YamamaSawalmeh/beeguard_Project/docs/images/app-feeding.jpg

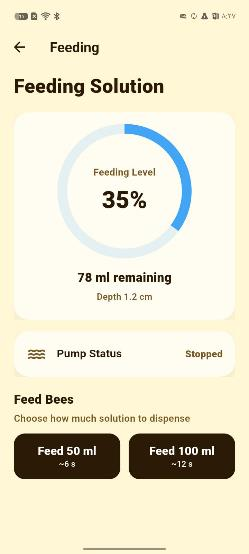
docs/images/app-feeding.jpg
