YamamaSawalmeh/beeguard_Project/docs/images/app-security.jpg

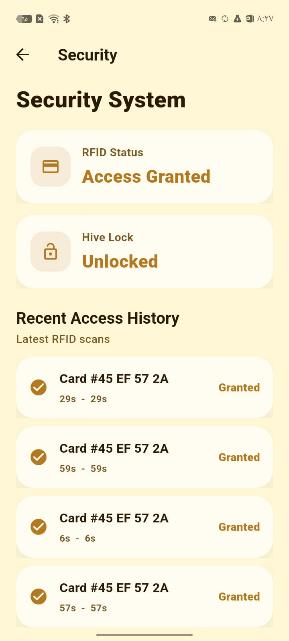
docs/images/app-security.jpg
