YamamaSawalmeh/beeguard_Project/SETUP_V5.md

# BeeGuard v5 — دليل التشغيل والمعايرة

هذا الملف بيشرح شو تغيّر وشو لازم تعمله قبل ما النظام يشتغل صح.

---

## ١. أهم إشي: الواي فاي لازم يكون نفسه على الثلاث بوردات

**ESP-NOW بيوصل بس بين بوردات على نفس قناة الواي فاي.** والقناة بتتحدد من
الراوتر اللي البورد متصلة فيه — مش من إعداد بالكود.

قبل التعديل كان الوضع:

| البورد | SSID |
|---|---|
| المتحكم الرئيسي | `GP` |
| الكاميرا | `MSI` |
| بورد الصوت | ما كان فيها واي فاي أصلاً |

يعني حتى لو الـ MAC صح، `esp_now_send()` بترجّع `ESP_OK` بس الباكت بتضيع
بالهوا. هذا السبب الأساسي إنه الحرارة والرطوبة والصوت ما كانوا يوصلوا للتطبيق.

هلأ الثلاثة متضبطين على `MSI` / `123456789`. **إذا شبكتك اسمها غير، غيّرها
بالثلاث ملفات مع بعض:**

- `BeeGuard_Main_Controller.ino` → `WIFI_SSID` / `WIFI_PASSWORD`
- `BEE_HIVE_MONITOR.ino` → `WIFI_SSID` / `WIFI_PASSWORD`
- `esp32cam_hive_guard.ino` → `ssid` / `password`

**طريقة التأكد:** كل بورد بتطبع القناة على السيريال وقت الإقلاع:

```
[WiFi] Channel: 6  (camera + audio boards MUST match)
```

لازم الثلاث أرقام تكون نفسها. إذا مش نفسها، ESP-NOW ما رح يشتغل.

> ملاحظة: الموبايل كمان لازم يكون على نفس الشبكة عشان يشوف ستريم الكاميرا
> (`http://192.168.137.150/`) — هذا IP محلي، مش على الإنترنت.

---

## ٢. المعايرة — بدونها الأرقام غلط

### أ) معايرة الميزان (HX711)

`SCALE_CALIBRATION_FACTOR = -7050.0` اللي كان بالكود هو رقم من مثال المكتبة،
مش رقم خليتك، وبيطلع **باوند مش كيلو**. لازم تقيسه:

1. شغّل الخلية فاضية (بدون وزن على الحساس).
2. من التطبيق أو من Firebase console: `commands/tare_scale = true`.
   البورد بتعمل tare وبتخزّن الصفر بـ `calibration/tare_offset`.
3. حط وزن معروف (مثلاً ٥ كيلو).
4. اقرأ `hive_status/weight` من Firebase.
5. احسب: `عامل_جديد = العامل_الحالي × (القراءة ÷ الوزن_الحقيقي)`
6. اكتب الناتج بـ `calibration/scale_factor` بالـ Firebase console.
   البورد بتقراه عند كل إقلاع — **مش لازم ترفع الكود من جديد**.

> **مهم:** الكود القديم كان بيعمل `scale.tare()` كل مرة بالـ `setup()`، يعني
> كل ريستارت الوزن بيرجع صفر والخلية عليه. هذا انشال — الصفر صار محفوظ
> بـ Firebase وبيرجع لحاله بعد الكهرباء.

### ب) معايرة خزان التغذية (الألتراسونيك)

المعادلة الحسابية نفسها كانت **صح**:

```
waterHeight = CONTAINER_HEIGHT - (distance - SENSOR_TO_TOP)
```

- خزان فاضي: المسافة = ٤ + ٣٫٥ = ٧٫٥ سم → الارتفاع = ٠ ✓
- خزان مليان: المسافة = ٤ سم → الارتفاع = ٣٫٥ ✓

**بس كان فيها باغ خطير:** لما `pulseIn()` تعمل timeout بترجّع `0`، والمعادلة
كانت بتحسب `3.5 - (0 - 4) = 7.5` → بعد الـ constrain بتطلع **١٠٠٪ مليان**.
يعني حساس ميّت كان بيتقرأ خزان مليان — بالضبط عكس اللي بدك ياه من تحذير.

الجديد:
- ٥ قراءات وبناخد الـ **median** (مش المتوسط — عشان صدى شارد ينرمى مش يأثر)
- timeout → `NAN` → بيضل يعرض آخر قراءة صحيحة + بيطلع تنبيه `sensor_fault`
- سرعة الصوت صارت متعوّضة بالحرارة: `331.3 + 0.606×T` م/ث
- بيحسب كمان **الحجم المتبقي بالمليلتر** — أهم من النسبة لما تكون بدك تعرف
  إذا بيكفي لجرعة ١٠٠ مل

قيس الأبعاد الحقيقية واكتبها بـ `calibration`:

| المفتاح | يعني | الافتراضي |
|---|---|---|
| `sensor_to_top_cm` | من وجه الحساس لحافة الخزان | 4.0 |
| `container_height_cm` | من الحافة لقاع الخزان | 3.5 |
| `container_diameter_cm` | قطر الخزان (لحساب المليلتر) | 9.0 |

> ملاحظة: HC-SR04 أقل مسافة بيقيسها ≈ ٢ سم. مع `sensor_to_top_cm = 4`
> والخزان مليان المسافة بتصير ٤ سم — قريبة بس مقبولة. إذا نزّلت الحساس أقرب
> من هيك، القراءات بتصير غلط.

### ج) خط الأساس للعسل (baseline)

بدون baseline، تقدير العسل بيحسب **وزن الخلية كلها** (الصندوق والبراويز
والنحل) على إنه عسل — يعني ٢٤ كيلو عسل، وهذا غلط فاضح مش تقريب.

من شاشة **Honey Collection** اضغط **Set baseline now** لما تكون الخلية بدون
عسل جاهز للقطف. بعدها:

```
estimated_honey = (الوزن الحالي − baseline) × honey_fraction
```

`honey_fraction` افتراضياً `0.85` — لأنه مش كل زيادة الوزن عسل، جزء منها شمع
وحضنة ونحل. عدّلها بـ `calibration/honey_fraction` بعد ما تقطف أول مرة وتوزن
الناتج الفعلي.

---

## ٣. شو تغيّر بالتفصيل

### مدخل الخلية (Open / Narrow)

انعكست الزوايا بالفيرموير:

```c
#define ENTRANCE_OPEN_ANGLE   180   // كانت 0
#define ENTRANCE_NARROW_ANGLE 0     // كانت 180
```

يعني السلوك الفيزيائي انعكس عن اللي كان: "Open Entrance" بالتطبيق هلأ بتعطي
الوضع اللي كان "Narrow" بيعطيه. أسماء الأزرار وقيم Firebase ضلّت زي ما هي
وصحيحة — إذا ركّبت السيرفو بالعكس مستقبلاً، بدّل الرقمين بس.

**ليش بالفيرموير مش بتبديل أسماء الأزرار بالتطبيق؟**
لأنه المدخل مش بس أزرار — الكاميرا لما تكشف دبور، المتحكم بينادي
`narrowEntrance()` أوتوماتيكياً. لو بدّلنا الأسماء بالتطبيق بس، بتصير
`entrance = "narrow"` معناها فيزيائياً "مفتوح"، ووقتها الاستجابة التلقائية
**بتفتح** المدخل لما ييجي دبور بدل ما تضيّقه — يعني بتصير تدعوه يفوت.
تبديل الزوايا بالفيرموير بيصلّح الاتجاه الفيزيائي وبيخلي كل المعاني صحيحة.

> إذا اللي كنت تقصده فعلاً هو تبديل نص الأزرار بالواجهة بس، خبّرني — بس
> الاستجابة التلقائية للدبور بدها تنعكس معها عشان تضل صح.

**فتح تلقائي بعد ما يروح الدبور (سلوك جديد):**
قبل هيك، أول ما تكشف الكاميرا دبور المدخل بيضيق **وبيضل ضيّق للأبد** لحد ما
حدا يفتح التطبيق ويوسّعه. يعني دبور واحد مرّ الصبح بيخلي الخلية مخنوقة تهوية
وحركة سروح طول اليوم إذا ما انتبهت.

هلأ بيرجع يفتح لحاله بعد **١٠ دقايق** بدون أي كشف:

```c
const unsigned long HORNET_REOPEN_DELAY_MS = 10UL * 60UL * 1000UL;
```

- التأخير موجود عشان ما يفتح ويسكّر كل ما الدبور يدخل ويطلع من كادر الكاميرا.
- إذا **إنت** ضيّقت المدخل من التطبيق، بيضل زي ما تركته — الفتح التلقائي
  بيلغي بس التضييق اللي عمله النظام نفسه.
- إذا بدك ترجعه للسلوك القديم (يضل ضيّق لحد ما تفتحه بإيدك)، حط القيمة `0`.

### الكاميرا

- **الكشف صار شغال ٢٤ ساعة.** قبل هيك كان الكشف جوّا `stream_handler()` بس —
  يعني الخلية كانت محروسة فقط لما يكون حدا فاتح الفيديو. هلأ `loop()` بتفحص
  فريم كل نص ثانية لما ما يكون في متفرج.
- **endpoint جديد `/status`** بيرجّع JSON فيه وقت آخر كشف مؤكد:
  ```json
  {"count":0,"detected":false,"ever_detected":true,"since_seconds":142,
   "last_count":2,"total_detections":7,"uptime_seconds":9310}
  ```
- **نبضة كل ٣٠ ثانية** للمتحكم الرئيسي، عشان يعرف إنه الكاميرا عايشة حتى لو
  ما في دبابير (قبل هيك كانت بتبعث بس عند تغيّر الحالة، فبتظهر أوفلاين دايماً).
- الكاميرا ما عندها ساعة، فبتبعث "كم ثانية صار من آخر كشف" والمتحكم الرئيسي
  (اللي عنده NTP) بيحوّلها لوقت حقيقي. فايدة إضافية: لو المتحكم عمل ريستارت،
  بيرجّع وقت آخر كشف من الكاميرا بدل ما يضيع.

### بورد الصوت

كانت **ما بتبعث ولا إشي** — لا ESP-NOW ولا واي فاي، النتيجة بتوقف عالشاشة.
انضاف:

- إرسال ESP-NOW كل ٢٠ ثانية (حرارة + رطوبة)
- إرسال نتيجة التصنيف بعد كل تحليل
- **تحليل تلقائي كل ١٥ دقيقة** — قبل هيك كان لازم حدا يوقف جنب الخلية ويضغط
  الزر عشان تتحدث النتيجة
- كرت SD خربان ما عاد يعلّق البورد بـ `while(1)` — بتكمل تبعث حرارة ورطوبة

**ترجمة أسماء الأصناف:** الموديل بيطلع `Active` / `Queen_Loss`، بينما التطبيق
والمتحكم بيفهموا `Normal` / `Swarming` / `Queen Loss`. الترجمة صارت بدالة
`normalizeLabel()` — لو دربت الموديل من جديد بأسماء غير، عدّل هاي الدالة بس.

> بدون هاي الترجمة، كل قراءة كانت بتنحسب غير طبيعية و `health_score` بيضل
> ناقص ٣٠ نقطة على طول.

### الإشعارات

- **وقت حقيقي (NTP)** بدل `"just now"` الثابتة و `millis()/1000 + "s"`
- **severity**: `info` / `warning` / `critical`
- **throttle**: التنبيهات المستمرة (مي قليلة، حرارة عالية) بتنكتب مرة كل ١٥
  دقيقة. قبل هيك كانت بتضيف node جديدة **كل ٣٠ ثانية للأبد** طول ما المستوى
  واطي — يعني آلاف الـ nodes بالأسبوع.
- أحداث جديدة: فتح/سكر الباب، الدخان، الطرمبة، التغذية، RFID، الدبور
  وانتهاؤه، ضيق/فتح المدخل، القطف، المعايرة، عطل الحساسات، انقطاع البوردات،
  الإقلاع.
- التطبيق: badge بعدد غير المقروء على الداشبورد، فلترة، و"تعليم الكل كمقروء".

### الإنتاج

- `production/history/YYYY-MM-DD` — سجل يومي حقيقي.
  الرسم البياني كان `[today×0.5, today×0.7, today×0.6, ...]` — شكل ثابت ما
  بيتغيّر مهما عملت الخلية. هلأ بيرسم أرقام فعلية.
- كشف القطف: نزول مفاجئ بالوزن (> ٥٠٠ غم) والباب مفتوح → بينسجل كقطف،
  والـ baseline بينزل معه.
- عدّادات أسبوعية وشهرية بتصفّر مع بداية الأسبوع/الشهر.

---

## ٤. قائمة التحقق بعد الرفع

ارفع الثلاث ملفات، وبعدين افحص بالترتيب:

1. **السيريال لكل بورد**: نفس رقم القناة على الثلاثة؟
2. **المتحكم**: `[TIME] 2026-08-20 14:33:10` — إذا طلع `uptime ...s` يعني NTP
   فشل، افحص الإنترنت.
3. **بورد الصوت**: `[ESP-NOW] Sent T=34.2 H=61.8 Normal 0% fresh=0`
4. **المتحكم**: `[Firebase] T:34.2 H:61.8 W:...` — إذا الحرارة صفر، الباكتات
   مش واصلة (ارجع للنقطة ١).
5. **Firebase console**: `hive_status/audio_node_online` و
   `hive_status/camera_node_online` لازم يصيروا `true` خلال دقيقتين.
6. **المتصفح**: افتح `http://192.168.137.150:81/status` — لازم يرجّع JSON.
7. **التطبيق**: شاشة Hornet Detection — الفيديو شغال وبتحته "Last Detection".
8. اعمل معايرة الميزان والخزان والـ baseline (القسم ٢).

### إذا الفيديو ما ظهر بالتطبيق

- افتح `http://192.168.137.150/` بمتصفح الموبايل. إذا ما اشتغل هناك
  كمان، المشكلة بالشبكة مش بالتطبيق.
- الموبايل لازم يكون على نفس شبكة الكاميرا.
- Android: `network_security_config.xml` بيسمح بـ HTTP العادي (مضاف).
- iOS: أول مرة بيطلع سؤال إذن "Local Network" — لازم توافق.
- IP الكاميرا محفوظ بـ `camera/stream_url` بـ Firebase، فإذا تغيّر عدّله من
  الـ console بدون ما ترفع التطبيق من جديد.

---

## ٥. ملاحظة على الذاكرة (بورد الصوت)

إضافة الواي فاي على بورد فيها Edge Impulse + I2S + SD بتاخد ذاكرة. البورد
بتطبع الفاضي عند الإقلاع:

```
[MEM] Free heap before WiFi: 245678 bytes
[MEM] Free heap after  WiFi: 198432 bytes
```

إذا الرقم الثاني نزل تحت ~٥٠ كيلوبايت، التصنيف ممكن يفشل بـ out-of-memory.
الحل وقتها: قلّل `I2S_READ_LEN` أو استعمل بورد فيها PSRAM.

---

## ٦. تحديثات v5.1 (حسب ملاحظاتك من الميدان)

### أ) رابط الستريم صار على الجذر
الفيديو المباشر هلأ على **`http://192.168.137.150/`** بالضبط (بورت 80، بدون
`:81/stream`). داخلياً بدّلنا البوردات: بورت 80 مخصّص للستريم بس (لأن معالج
الستريم بيحبس الخيط)، و`/status` و`/count` واللوحة انتقلوا لبورت 81. التطبيق
وقاعدة البيانات (`camera/stream_url`) صاروا يشيروا للجذر تلقائياً.

### ب) السيرفو ما بتتحرك رغم إنه الكشف شغال → صار البث broadcast
المشكلة إنه ESP-NOW كان بيبعت لـ MAC محدد للمتحكم
(`EC:E3:34:45:C6:94`). لو هذا الـ MAC مش مطابق للـ MAC الحقيقي تبع المتحكم،
`esp_now_send` بترجّع `ESP_OK` بس الباكت بتضيع — فالكشف يشتغل والسيرفو ما
بتتحرك، بالضبط اللي وصفته.

الحل: الكاميرا صارت تبعت **broadcast** (`FF:FF:FF:FF:FF:FF`) بدل MAC محدد.
استقبال ESP-NOW ما بيصفّي حسب المرسل، فالمتحكم بيستقبلها بغض النظر عن الـ MAC.
كمان ضفنا **callback تأكيد تسليم** بيطبع على سيريال الكاميرا:

```
[ESP-NOW] delivery OK        <- وصلت للمتحكم
[ESP-NOW] delivery FAIL (no ACK)  <- ما وصلت: القناة غلط أو المتحكم مطفّي
```

**للتشخيص:** إفتح Serial Monitor للكاميرا لما تكشف دبور. لو طلع `delivery OK`
والسيرفو ما تحرّكت → المشكلة بتوصيل السيرفو أو المتحكم. لو `FAIL` دايماً →
البوردتين مش على نفس قناة الواي فاي (تأكد إنهم على نفس الراوتر MSI، وقارن رقم
`[WiFi] Channel:` على البوردتين).

> إذا بعرفت الـ MAC الحقيقي للمتحكم (بيطبعه عند الإقلاع: `[ESP-NOW] MAC: ...`)
> وحابب ترجع unicast، حدّث `ESP32_MAIN_MAC` بالكاميرا — بس broadcast بيشتغل
> بدون ما تعرفه.

### ج) الوزن التقديري بيضل فاضي → baseline افتراضي ٤ كيلو
حطينا baseline افتراضي **٤ كيلو** (وزن الصندوق الفاضي تقريباً) بالفيرموير
وقاعدة البيانات والتطبيق، فقيمة "Estimated Honey Ready" ما عادت تطلع فاضية.
التقدير = `(وزن الخلية − ٤) × 0.85`. التطبيق كمان بيحسبها محلياً لو المتحكم
لسا ما كتبها، فبتشوف رقم فوراً.

> ملاحظة مهمة: هذا رقم **عرض** مؤقت. الميزان نفسه (`scale_factor = -7050`)
> لسا بدو معايرة حقيقية (القسم ٢-أ) عشان وزن الخلية يطلع صح — بدونها الوزن
> غلط والتقدير المبني عليه غلط. لما تعاير وتضبط baseline حقيقي من زر
> **Set Baseline**، بتصير الأرقام دقيقة.
