YamamaSawalmeh/beeguard_Project/firmware/BEE_HIVE_MONITOR/BEE_HIVE_MONITOR.ino

/*
 
  INMP441 (I2S Mic)
    SCK/BCLK -> GPIO 27
    WS/LRCL  -> GPIO 13
    SD/DOUT  -> GPIO 34
    VCC      -> 3.3V
    GND      -> GND

  MicroSD (SPI)
    CS   -> GPIO 5
    SCK  -> GPIO 18
    MISO -> GPIO 19
    MOSI -> GPIO 26
    VCC  -> 5V 
    GND  -> GND

 
    RECORD  -> GPIO 32
    ANALYZE -> GPIO 33

   LCD (I2C)
    SDA -> GPIO 21
    SCL -> GPIO 25
    VCC -> حسب الشاشة
    GND -> GND

  DHT11
    DATA -> GPIO 4   
 (Library Manager):
    - LiquidCrystal I2C  (Frank de Brabander أو Marco Schwartz)
    - DHT sensor library (Adafruit)
    - Adafruit Unified Sensor 
    - ff_inferencing (   Active / Queen_Loss)
  ============================================================================
*/

#include <driver/i2s.h>
#include <SPI.h>
#include <SD.h>
#include <Wire.h>
#include <LiquidCrystal_I2C.h>
#include <DHT.h>
#include <math.h>
#include <WiFi.h>
#include <esp_now.h>
#include <esp_wifi.h>
#include <ff_inferencing.h>


#define WIFI_SSID     "MSI"
#define WIFI_PASSWORD "123456789"

uint8_t ESP32_MAIN_MAC[] = { 0xEC, 0xE3, 0x34, 0x45, 0xC6, 0x94 };

#define MSG_SENSOR 1
#define MSG_CAM    2

typedef struct __attribute__((packed)) {
  uint8_t msgType;         // MSG_SENSOR
  float   temperature;
  float   humidity;
  char    soundResult[20];
  uint8_t confidence;      
  uint8_t freshAnalysis;   
} SensorData;

char lastSoundLabel[20] = "Unknown";
int  lastSoundConfidence = 0;

bool espNowReady = false;
unsigned long lastEspNowSend = 0;
const unsigned long ESPNOW_SEND_INTERVAL = 20000UL;   //   

const unsigned long AUTO_ANALYZE_INTERVAL = 15UL * 60UL * 1000UL;  //   
unsigned long lastAutoAnalyze = 0;



// ---- INMP441 (I2S) ----
#define I2S_BCLK   GPIO_NUM_27
#define I2S_WS     GPIO_NUM_13
#define I2S_SD     GPIO_NUM_34
#define I2S_PORT            I2S_NUM_0
#define I2S_SAMPLE_RATE     (16000)
#define I2S_READ_LEN        (16 * 1024)
#define BYTES_PER_SAMPLE    (2)

// ---- MicroSD (SPI) ----
#define SD_CS    5
#define SD_SCK   18
#define SD_MISO  19
#define SD_MOSI  26
SPIClass sdSPI(VSPI);

// ---- الأزرار ----
#define BTN_RECORD   32
#define BTN_ANALYZE  33
#define DEBOUNCE_MS  250

#define LCD_ADDR  0x27
#define LCD_COLS  16
#define LCD_ROWS  2
#define LCD_SDA   21
#define LCD_SCL   25
LiquidCrystal_I2C lcd(LCD_ADDR, LCD_COLS, LCD_ROWS);

// ---- DHT11 ----
#define DHT_PIN   4     
#define DHT_TYPE  DHT11
DHT dht(DHT_PIN, DHT_TYPE);


#define RECORD_MINUTES        1
#define RECORD_SECONDS_LONG   (RECORD_MINUTES * 60UL)
#define ANALYZE_SECONDS       10

#define TARGET_DBFS   -20.0
#define PEAK_LIMIT    0.99
const int headerSize = 44;

const char* ANALYZE_RAW_FILE  = "/analyze_raw.wav";
const char* ANALYZE_PROC_FILE = "/analyze_proc.wav";

// ============================================================================
// ============================================================================
static double dc_x_prev = 0.0;
static double dc_y_prev = 0.0;
const double DC_FILTER_R = 0.995;

static inline double dc_block(double x) {
  double y = x - dc_x_prev + DC_FILTER_R * dc_y_prev;
  dc_x_prev = x;
  dc_y_prev = y;
  return y;
}

struct BiquadCoeffs { double b0, b1, b2, a1, a2; };
struct BiquadState  { double z1 = 0.0, z2 = 0.0; };

static const BiquadCoeffs sections[4] = {
  { 0.0086086972,  0.0172173944,  0.0086086972, -0.9321840550,  0.2476487208 },
  { 1.0000000000,  2.0000000000,  1.0000000000, -1.1438490990,  0.6042562289 },
  { 1.0000000000, -2.0000000000,  1.0000000000, -1.9235752203,  0.9253348864 },
  { 1.0000000000, -2.0000000000,  1.0000000000, -1.9708723639,  0.9724296607 }
};
static BiquadState states[4];

static inline double bandpass_filter_sample(double x) {
  double in = x;
  for (int s = 0; s < 4; s++) {
    double out = sections[s].b0 * in + states[s].z1;
    states[s].z1 = sections[s].b1 * in - sections[s].a1 * out + states[s].z2;
    states[s].z2 = sections[s].b2 * in - sections[s].a2 * out;
    in = out;
  }
  return in;
}

static void resetFilters() {
  dc_x_prev = 0.0;
  dc_y_prev = 0.0;
  for (int s = 0; s < 4; s++) { states[s].z1 = 0.0; states[s].z2 = 0.0; }
}

// ============================================================================
// ============================================================================
static int16_t clsBuffer[EI_CLASSIFIER_RAW_SAMPLE_COUNT];

static int classify_signal_get_data(size_t offset, size_t length, float *out_ptr) {
  numpy::int16_to_float(&clsBuffer[offset], out_ptr, length);
  return 0;
}

// ============================================================================
// ============================================================================
enum SystemState { STATE_IDLE, STATE_RECORDING, STATE_ANALYZING, STATE_DONE_MSG };
volatile SystemState sysState = STATE_IDLE;

unsigned long lastBtnRecord  = 0;
unsigned long lastBtnAnalyze = 0;
unsigned long lastSensorUpdate = 0;
unsigned long doneMsgSince = 0;

float lastTemp = NAN;
float lastHum  = NAN;

bool sdReady = false;


void normalizeLabel(const char *raw, char *out, size_t outLen) {
  String s = String(raw);
  s.trim();
  String lower = s;
  lower.toLowerCase();

  const char *mapped;
  if (lower == "active" || lower == "normal" || lower == "healthy") {
    mapped = "Normal";
  } else if (lower == "queen_loss" || lower == "queenloss" || lower == "queen loss") {
    mapped = "Queen Loss";
  } else if (lower == "swarm" || lower == "swarming") {
    mapped = "Swarming";
  } else if (lower.length() == 0) {
    mapped = "Unknown";
  } else {
    mapped = s.c_str();
  }

  strncpy(out, mapped, outLen - 1);
  out[outLen - 1] = '\0';
}

void espNowInit() {
  WiFi.mode(WIFI_STA);
  WiFi.setSleep(false);   

 
  WiFi.begin(WIFI_SSID, WIFI_PASSWORD);
  Serial.print("[WiFi] Connecting");
  unsigned long start = millis();
  while (WiFi.status() != WL_CONNECTED && millis() - start < 15000UL) {
    delay(300);
    Serial.print(".");
  }
  Serial.println();

  if (WiFi.status() == WL_CONNECTED) {
    Serial.println("[WiFi] Connected: " + WiFi.localIP().toString());
  } else {
    Serial.println("[WiFi] NOT connected — ESP-NOW may be on the wrong channel");
  }
  Serial.printf("[WiFi] Channel: %d  (must match the main controller)\n", WiFi.channel());
  Serial.println("[ESP-NOW] My MAC: " + WiFi.macAddress());

  if (esp_now_init() != ESP_OK) {
    Serial.println("[ESP-NOW] INIT FAILED");
    return;
  }

  esp_now_peer_info_t peer = {};
  memcpy(peer.peer_addr, ESP32_MAIN_MAC, 6);
  peer.channel = 0;       
  peer.encrypt = false;

  if (esp_now_add_peer(&peer) != ESP_OK) {
    Serial.println("[ESP-NOW] Failed to add main controller as peer");
    return;
  }

  espNowReady = true;
  Serial.println("[ESP-NOW] Ready — sending to EC:E3:34:45:C6:94");
}

void sendSensorPacket(bool freshAnalysis) {
 
  lastEspNowSend = millis();
  if (!espNowReady) return;

  SensorData pkt = {};
  pkt.msgType = MSG_SENSOR;

  
  pkt.temperature   = lastTemp;
  pkt.humidity      = lastHum;
  pkt.confidence    = (uint8_t)constrain(lastSoundConfidence, 0, 100);
  pkt.freshAnalysis = freshAnalysis ? 1 : 0;
  strncpy(pkt.soundResult, lastSoundLabel, sizeof(pkt.soundResult) - 1);

  esp_err_t res = esp_now_send(ESP32_MAIN_MAC, (uint8_t *)&pkt, sizeof(pkt));
  lastEspNowSend = millis();

  if (res == ESP_OK) {
    Serial.printf("[ESP-NOW] Sent T=%.1f H=%.1f %s %d%% fresh=%d\n",
                  pkt.temperature, pkt.humidity, pkt.soundResult,
                  pkt.confidence, pkt.freshAnalysis);
  } else {
    Serial.printf("[ESP-NOW] Send failed (%d)\n", res);
  }
}


void refreshDht() {
  float t = dht.readTemperature();
  float h = dht.readHumidity();
  if (!isnan(t) && !isnan(h)) {
    lastTemp = t;
    lastHum  = h;
  }
}


  delay(300);

  pinMode(BTN_RECORD, INPUT_PULLUP);
  pinMode(BTN_ANALYZE, INPUT_PULLUP);

  Wire.begin(LCD_SDA, LCD_SCL);
  lcd.init();
  lcd.backlight();
  lcdShowIdle();

  dht.begin();
  refreshDht();        
  i2sInit();

  sdSPI.begin(SD_SCK, SD_MISO, SD_MOSI, SD_CS);
  if (!SD.begin(SD_CS, sdSPI)) {
   
    sdReady = false;
    Serial.println("!!! فشل تهيئة SD Card — التسجيل والتحليل معطلين");
    lcd.clear();
    lcd.setCursor(0, 0); lcd.print("SD Card ERROR");
    lcd.setCursor(0, 1); lcd.print("Sensors only");
    delay(2500);
  } else {
    sdReady = true;
    Serial.println("SD Card جاهزة");
  }

 
  Serial.printf("[MEM] Free heap before WiFi: %u bytes\n", ESP.getFreeHeap());
  espNowInit();
  Serial.printf("[MEM] Free heap after  WiFi: %u bytes\n", ESP.getFreeHeap());

  sendSensorPacket(false);   
  lastAutoAnalyze = millis();

  lcdShowIdle();
  Serial.println("جاهز! زر RECORD يبدأ تسجيل، زر ANALYZE يحلل عينة 10 ثواني.");
}

void loop() {
  handleButtons();
  updateSensorDisplay();

  if (sysState == STATE_DONE_MSG && millis() - doneMsgSince > 4000) {
    sysState = STATE_IDLE;
    lcdShowIdle();
  }

 
  if (millis() - lastEspNowSend >= ESPNOW_SEND_INTERVAL) {
    refreshDht();
    sendSensorPacket(false);
  }

  
  if (sysState == STATE_IDLE && sdReady &&
      millis() - lastAutoAnalyze >= AUTO_ANALYZE_INTERVAL) {
    lastAutoAnalyze = millis();
    Serial.println("[AUTO] بدء تحليل دوري");
    startAnalysis();
  }
}


void handleButtons() {
  if (sysState != STATE_IDLE) return;

  if (!sdReady) return;

  if (digitalRead(BTN_RECORD) == LOW && millis() - lastBtnRecord > DEBOUNCE_MS) {
    lastBtnRecord = millis();
    startLongRecording();
  }

  if (digitalRead(BTN_ANALYZE) == LOW && millis() - lastBtnAnalyze > DEBOUNCE_MS) {
    lastBtnAnalyze = millis();
    lastAutoAnalyze = millis();
    startAnalysis();
  }
}


void updateSensorDisplay() {
  if (sysState != STATE_IDLE) return;
  if (millis() - lastSensorUpdate < 2000) return;
  lastSensorUpdate = millis();

  refreshDht();

  lcd.setCursor(0, 1);
  char line[17];
  if (!isnan(lastTemp) && !isnan(lastHum)) {
    snprintf(line, sizeof(line), "T:%.1fC H:%.0f%%  ", lastTemp, lastHum);
  } else {
    snprintf(line, sizeof(line), "DHT11 read err  ");
  }
  lcd.print(line);
}


void lcdShowIdle() {
  lcd.clear();
  lcd.setCursor(0, 0);
  lcd.print("BEE HIVE MONITOR");
  lcd.setCursor(0, 1);
  lcd.print("RECORD / ANALYZE");
  lastSensorUpdate = 0;
}


void i2sInit() {
  i2s_config_t i2s_config = {
    .mode = (i2s_mode_t)(I2S_MODE_MASTER | I2S_MODE_RX),
    .sample_rate = I2S_SAMPLE_RATE,
    .bits_per_sample = I2S_BITS_PER_SAMPLE_32BIT,
    .channel_format = I2S_CHANNEL_FMT_ONLY_LEFT,
    .communication_format = i2s_comm_format_t(I2S_COMM_FORMAT_STAND_I2S),
    .intr_alloc_flags = ESP_INTR_FLAG_LEVEL1,
    .dma_buf_count = 8,
    .dma_buf_len = 1024,
    .use_apll = false
  };
  i2s_driver_install(I2S_PORT, &i2s_config, 0, NULL);

  const i2s_pin_config_t pin_config = {
   
    .mck_io_num = I2S_PIN_NO_CHANGE,
    .bck_io_num = I2S_BCLK,
    .ws_io_num = I2S_WS,
    .data_out_num = I2S_PIN_NO_CHANGE,
    .data_in_num = I2S_SD
  };
  i2s_set_pin(I2S_PORT, &pin_config);
  i2s_zero_dma_buffer(I2S_PORT);
}


void wavHeader(byte *header, uint32_t wavSize) {
  header[0] = 'R'; header[1] = 'I'; header[2] = 'F'; header[3] = 'F';
  uint32_t fileSize = wavSize + headerSize - 8;
  header[4] = (byte)(fileSize & 0xFF);
  header[5] = (byte)((fileSize >> 8) & 0xFF);
  header[6] = (byte)((fileSize >> 16) & 0xFF);
  header[7] = (byte)((fileSize >> 24) & 0xFF);
  header[8] = 'W'; header[9] = 'A'; header[10] = 'V'; header[11] = 'E';
  header[12] = 'f'; header[13] = 'm'; header[14] = 't'; header[15] = ' ';
  header[16] = 0x10; header[17] = 0x00; header[18] = 0x00; header[19] = 0x00;
  header[20] = 0x01; header[21] = 0x00;
  header[22] = 0x01; header[23] = 0x00;
  header[24] = 0x80; header[25] = 0x3E; header[26] = 0x00; header[27] = 0x00;
  header[28] = 0x00; header[29] = 0x7D; header[30] = 0x00; header[31] = 0x00;
  header[32] = 0x02; header[33] = 0x00;
  header[34] = 0x10; header[35] = 0x00;
  header[36] = 'd'; header[37] = 'a'; header[38] = 't'; header[39] = 'a';
  header[40] = (byte)(wavSize & 0xFF);
  header[41] = (byte)((wavSize >> 8) & 0xFF);
  header[42] = (byte)((wavSize >> 16) & 0xFF);
  header[43] = (byte)((wavSize >> 24) & 0xFF);
}


void getNextRecordingName(char *outName, size_t outLen) {
  for (int i = 1; i < 1000; i++) {
    snprintf(outName, outLen, "/BEE_%03d.wav", i);
    if (!SD.exists(outName)) return;
  }
  snprintf(outName, outLen, "/BEE_OVERFLOW.wav");
}

void startLongRecording() {
  sysState = STATE_RECORDING;
  xTaskCreate(longRecordTask, "longRecordTask", 1024 * 12, NULL, 1, NULL);
}

void longRecordTask(void *arg) {
  char filename[32];
  getNextRecordingName(filename, sizeof(filename));

  Serial.printf("بدء تسجيل طويل: %s\n", filename);

  File f = SD.open(filename, FILE_WRITE);
  if (!f) {
    Serial.println("!!! فشل فتح ملف على SD");
    lcd.clear();
    lcd.setCursor(0, 0); lcd.print("SD WRITE ERROR");
    delay(2000);
    sysState = STATE_DONE_MSG;
    doneMsgSince = millis();
    vTaskDelete(NULL);
    return;
  }

  const uint32_t totalBytes = I2S_SAMPLE_RATE * BYTES_PER_SAMPLE * RECORD_SECONDS_LONG;
  byte header[headerSize];
  wavHeader(header, totalBytes);
  f.write(header, headerSize);

  resetFilters();

  uint8_t *i2s_read_buff = (uint8_t *)malloc(I2S_READ_LEN);
  int16_t *out_buff = (int16_t *)malloc(I2S_READ_LEN / 2);
  size_t bytes_read;

  i2s_read(I2S_PORT, i2s_read_buff, I2S_READ_LEN, &bytes_read, portMAX_DELAY);
  i2s_read(I2S_PORT, i2s_read_buff, I2S_READ_LEN, &bytes_read, portMAX_DELAY);

  uint32_t written = 0;
  unsigned long lastLcdUpdate = 0;

  while (written < totalBytes) {
    i2s_read(I2S_PORT, i2s_read_buff, I2S_READ_LEN, &bytes_read, portMAX_DELAY);
    int32_t *samples32 = (int32_t *)i2s_read_buff;
    size_t sampleCount = bytes_read / 4;

    for (size_t i = 0; i < sampleCount; i++) {
      double dc_removed = dc_block((double)samples32[i]) / 65536.0;
      double filtered = bandpass_filter_sample(dc_removed);

      if (filtered > 32767.0) filtered = 32767.0;
      if (filtered < -32768.0) filtered = -32768.0;
      out_buff[i] = (int16_t)filtered;
    }

    size_t bytesToWrite = sampleCount * 2;
    f.write((uint8_t *)out_buff, bytesToWrite);
    written += bytesToWrite;

    if (millis() - lastLcdUpdate > 1000) {
      lastLcdUpdate = millis();
      uint32_t elapsedSec   = written / (I2S_SAMPLE_RATE * BYTES_PER_SAMPLE);
      uint32_t remainingSec = RECORD_SECONDS_LONG - elapsedSec;
      lcdShowRecordingProgress(elapsedSec, remainingSec);
    }
  }

  f.close();
  free(i2s_read_buff);
  free(out_buff);

  Serial.printf("خلص التسجيل: %s\n", filename);

  lcd.clear();
  lcd.setCursor(0, 0); lcd.print("RECORDING");
  lcd.setCursor(0, 1); lcd.print("COMPLETE");
  delay(1200);
  lcd.clear();
  lcd.setCursor(0, 0); lcd.print("Saved to SD Card");
  lcd.setCursor(0, 1); lcd.print(filename);
  delay(2000);

  sysState = STATE_DONE_MSG;
  doneMsgSince = millis();
  vTaskDelete(NULL);
}

void lcdShowRecordingProgress(uint32_t elapsedSec, uint32_t remainingSec) {
  char line1[17], line2[17];
  uint32_t em = elapsedSec / 60,   es = elapsedSec % 60;
  uint32_t rm = remainingSec / 60, rs = remainingSec % 60;

  snprintf(line1, sizeof(line1), "RECORDING");
  snprintf(line2, sizeof(line2), "%02lu:%02lu / Rem %02lu:%02lu",
           (unsigned long)em, (unsigned long)es, (unsigned long)rm, (unsigned long)rs);

  lcd.setCursor(0, 0); lcd.print("RECORDING       ");
  lcd.setCursor(0, 1);
  char short2[17];
  snprintf(short2, sizeof(short2), "T:%02lu:%02lu R:%02lu:%02lu",
           (unsigned long)em, (unsigned long)es, (unsigned long)rm, (unsigned long)rs);
  lcd.print(short2);
}


void startAnalysis() {
  sysState = STATE_ANALYZING;
  xTaskCreate(analyzeTask, "analyzeTask", 1024 * 20, NULL, 1, NULL);
}

void analyzeTask(void *arg) {
  lcd.clear();
  lcd.setCursor(0, 0); lcd.print("ANALYZING...");
  lcd.setCursor(0, 1); lcd.print("Recording 10s");

  const uint32_t sampleTotal = I2S_SAMPLE_RATE * ANALYZE_SECONDS; // 160000 عينة
  const uint32_t totalBytes  = sampleTotal * BYTES_PER_SAMPLE;

  SD.remove(ANALYZE_RAW_FILE);
  SD.remove(ANALYZE_PROC_FILE);

  File rawFile = SD.open(ANALYZE_RAW_FILE, FILE_WRITE);
  if (!rawFile) {
    Serial.println("!!! فشل فتح ملف التحليل المؤقت على SD");
    analysisFail("SD WRITE ERR");
    return;
  }

  byte header[headerSize];
  wavHeader(header, totalBytes);
  rawFile.write(header, headerSize);

  resetFilters();
  double sumSquares = 0.0;
  double peakAbs = 0.0;
  uint32_t samplesDone = 0;

  uint8_t *i2s_read_buff = (uint8_t *)malloc(I2S_READ_LEN);
  int16_t *out_buff = (int16_t *)malloc(I2S_READ_LEN / 2);
  size_t bytes_read;

 
  if (!i2s_read_buff || !out_buff) {
    Serial.println("!!! فشل حجز الذاكرة للتحليل");
    free(i2s_read_buff);
    free(out_buff);
    rawFile.close();
    analysisFail("NO MEMORY");
    return;
  }

  i2s_read(I2S_PORT, i2s_read_buff, I2S_READ_LEN, &bytes_read, portMAX_DELAY);
  i2s_read(I2S_PORT, i2s_read_buff, I2S_READ_LEN, &bytes_read, portMAX_DELAY);

  uint32_t written = 0;
  while (written < totalBytes) {
    i2s_read(I2S_PORT, i2s_read_buff, I2S_READ_LEN, &bytes_read, portMAX_DELAY);
    int32_t *samples32 = (int32_t *)i2s_read_buff;
    size_t sampleCount = bytes_read / 4;

    for (size_t i = 0; i < sampleCount; i++) {
      double dc_removed = dc_block((double)samples32[i]) / 65536.0;
      double filtered = bandpass_filter_sample(dc_removed);

      sumSquares += filtered * filtered;
      double a = fabs(filtered);
      if (a > peakAbs) peakAbs = a;
      samplesDone++;

      if (filtered > 32767.0) filtered = 32767.0;
      if (filtered < -32768.0) filtered = -32768.0;
      out_buff[i] = (int16_t)filtered;
    }

    size_t bytesToWrite = sampleCount * 2;
    rawFile.write((uint8_t *)out_buff, bytesToWrite);
    written += bytesToWrite;
  }

  rawFile.close();
  free(i2s_read_buff);
  free(out_buff);

  lcd.setCursor(0, 1); lcd.print("Processing...   ");

  double rms = (samplesDone > 0) ? sqrt(sumSquares / (double)samplesDone) : 0.0;
  double target_rms = pow(10.0, TARGET_DBFS / 20.0) * 32767.0;
  double gain = (rms > 1e-9) ? (target_rms / rms) : 1.0;

  double peak_after = peakAbs * gain;
  double peak_limit_int16 = PEAK_LIMIT * 32767.0;
  if (peak_after > peak_limit_int16 && peakAbs > 1e-9) {
    gain = peak_limit_int16 / peakAbs;
  }

  Serial.printf("Analyze RMS=%.1f Peak=%.1f Gain=%.4f\n", rms, peakAbs, gain);

  File inFile  = SD.open(ANALYZE_RAW_FILE, FILE_READ);
  File outFile = SD.open(ANALYZE_PROC_FILE, FILE_WRITE);
  if (!inFile || !outFile) {
    Serial.println("!!! فشل فتح ملفات التطبيع");
    
    inFile.close();
    outFile.close();
    analysisFail("SD READ ERR");
    return;
  }

  wavHeader(header, totalBytes);
  outFile.write(header, headerSize);
  inFile.seek(headerSize);

  const size_t CHUNK = 2048;
  static int16_t buf[CHUNK];
  size_t n;
  while ((n = inFile.read((uint8_t *)buf, CHUNK * 2)) > 0) {
    size_t count = n / 2;
    for (size_t i = 0; i < count; i++) {
      double v = (double)buf[i] * gain;
      if (v > 32767.0) v = 32767.0;
      if (v < -32768.0) v = -32768.0;
      buf[i] = (int16_t)v;
    }
    outFile.write((uint8_t *)buf, count * 2);
  }
  inFile.close();
  outFile.close();

  lcd.setCursor(0, 1); lcd.print("Classifying...  ");

  File pf = SD.open(ANALYZE_PROC_FILE, FILE_READ);
  if (!pf) {
    Serial.println("!!! فشل فتح الملف المعالج للتصنيف");
    analysisFail("SD READ ERR");
    return;
  }
  pf.seek(headerSize);

  const size_t windowBytes = EI_CLASSIFIER_RAW_SAMPLE_COUNT * sizeof(int16_t);
  double sumScores[EI_CLASSIFIER_LABEL_COUNT] = {0};
  int windowCount = 0;
  size_t rn;

  while ((rn = pf.read((uint8_t *)clsBuffer, windowBytes)) == windowBytes) {
    signal_t signal;
    signal.total_length = EI_CLASSIFIER_RAW_SAMPLE_COUNT;
    signal.get_data = &classify_signal_get_data;

    ei_impulse_result_t result = { 0 };
    EI_IMPULSE_ERROR r = run_classifier(&signal, &result, false);

    if (r == EI_IMPULSE_OK) {
      for (size_t ix = 0; ix < EI_CLASSIFIER_LABEL_COUNT; ix++) {
        sumScores[ix] += result.classification[ix].value;
        Serial.printf("  [win %d] %s: ", windowCount, result.classification[ix].label);
        ei_printf_float(result.classification[ix].value);
        Serial.println();
      }
      windowCount++;
    } else {
      Serial.printf("ERR: run_classifier فشل (%d)\n", r);
    }
  }
  pf.close();

  if (windowCount == 0) {
    analysisFail("NO DATA");
    return;
  }

  int bestIdx = 0;
  double bestAvg = -1.0;
  for (size_t ix = 0; ix < EI_CLASSIFIER_LABEL_COUNT; ix++) {
    double avg = sumScores[ix] / windowCount;
    if (avg > bestAvg) {
      bestAvg = avg;
      bestIdx = ix;
    }
  }

  const char *bestLabel = ei_classifier_inferencing_categories[bestIdx];
  int bestPercent = (int)round(bestAvg * 100.0);

  Serial.printf("النتيجة النهائية: %s = %d%%\n", bestLabel, bestPercent);

 
  normalizeLabel(bestLabel, lastSoundLabel, sizeof(lastSoundLabel));
  lastSoundConfidence = bestPercent;
 
  sendSensorPacket(true);   

  lcd.clear();
  lcd.setCursor(0, 0); lcd.print("ANALYSIS RESULT");
  lcd.setCursor(0, 1);
  char resLine[17];
  snprintf(resLine, sizeof(resLine), "%s: %d%%", lastSoundLabel, bestPercent);
  lcd.print(resLine);

  delay(4000);

  sysState = STATE_DONE_MSG;
  doneMsgSince = millis();
  vTaskDelete(NULL);
}

void analysisFail(const char *reason) {
  lcd.clear();
  lcd.setCursor(0, 0); lcd.print("ANALYSIS FAILED");
  lcd.setCursor(0, 1); lcd.print(reason);
  delay(2500);
  sysState = STATE_DONE_MSG;
  doneMsgSince = millis();
  vTaskDelete(NULL);
}
